leschi4banane/kugel-keyboard/pcb/kugel-keyboard.kicad_pcb

## KiCad design pcb/kugel-keyboard.kicad_pcb (2025-03-04)

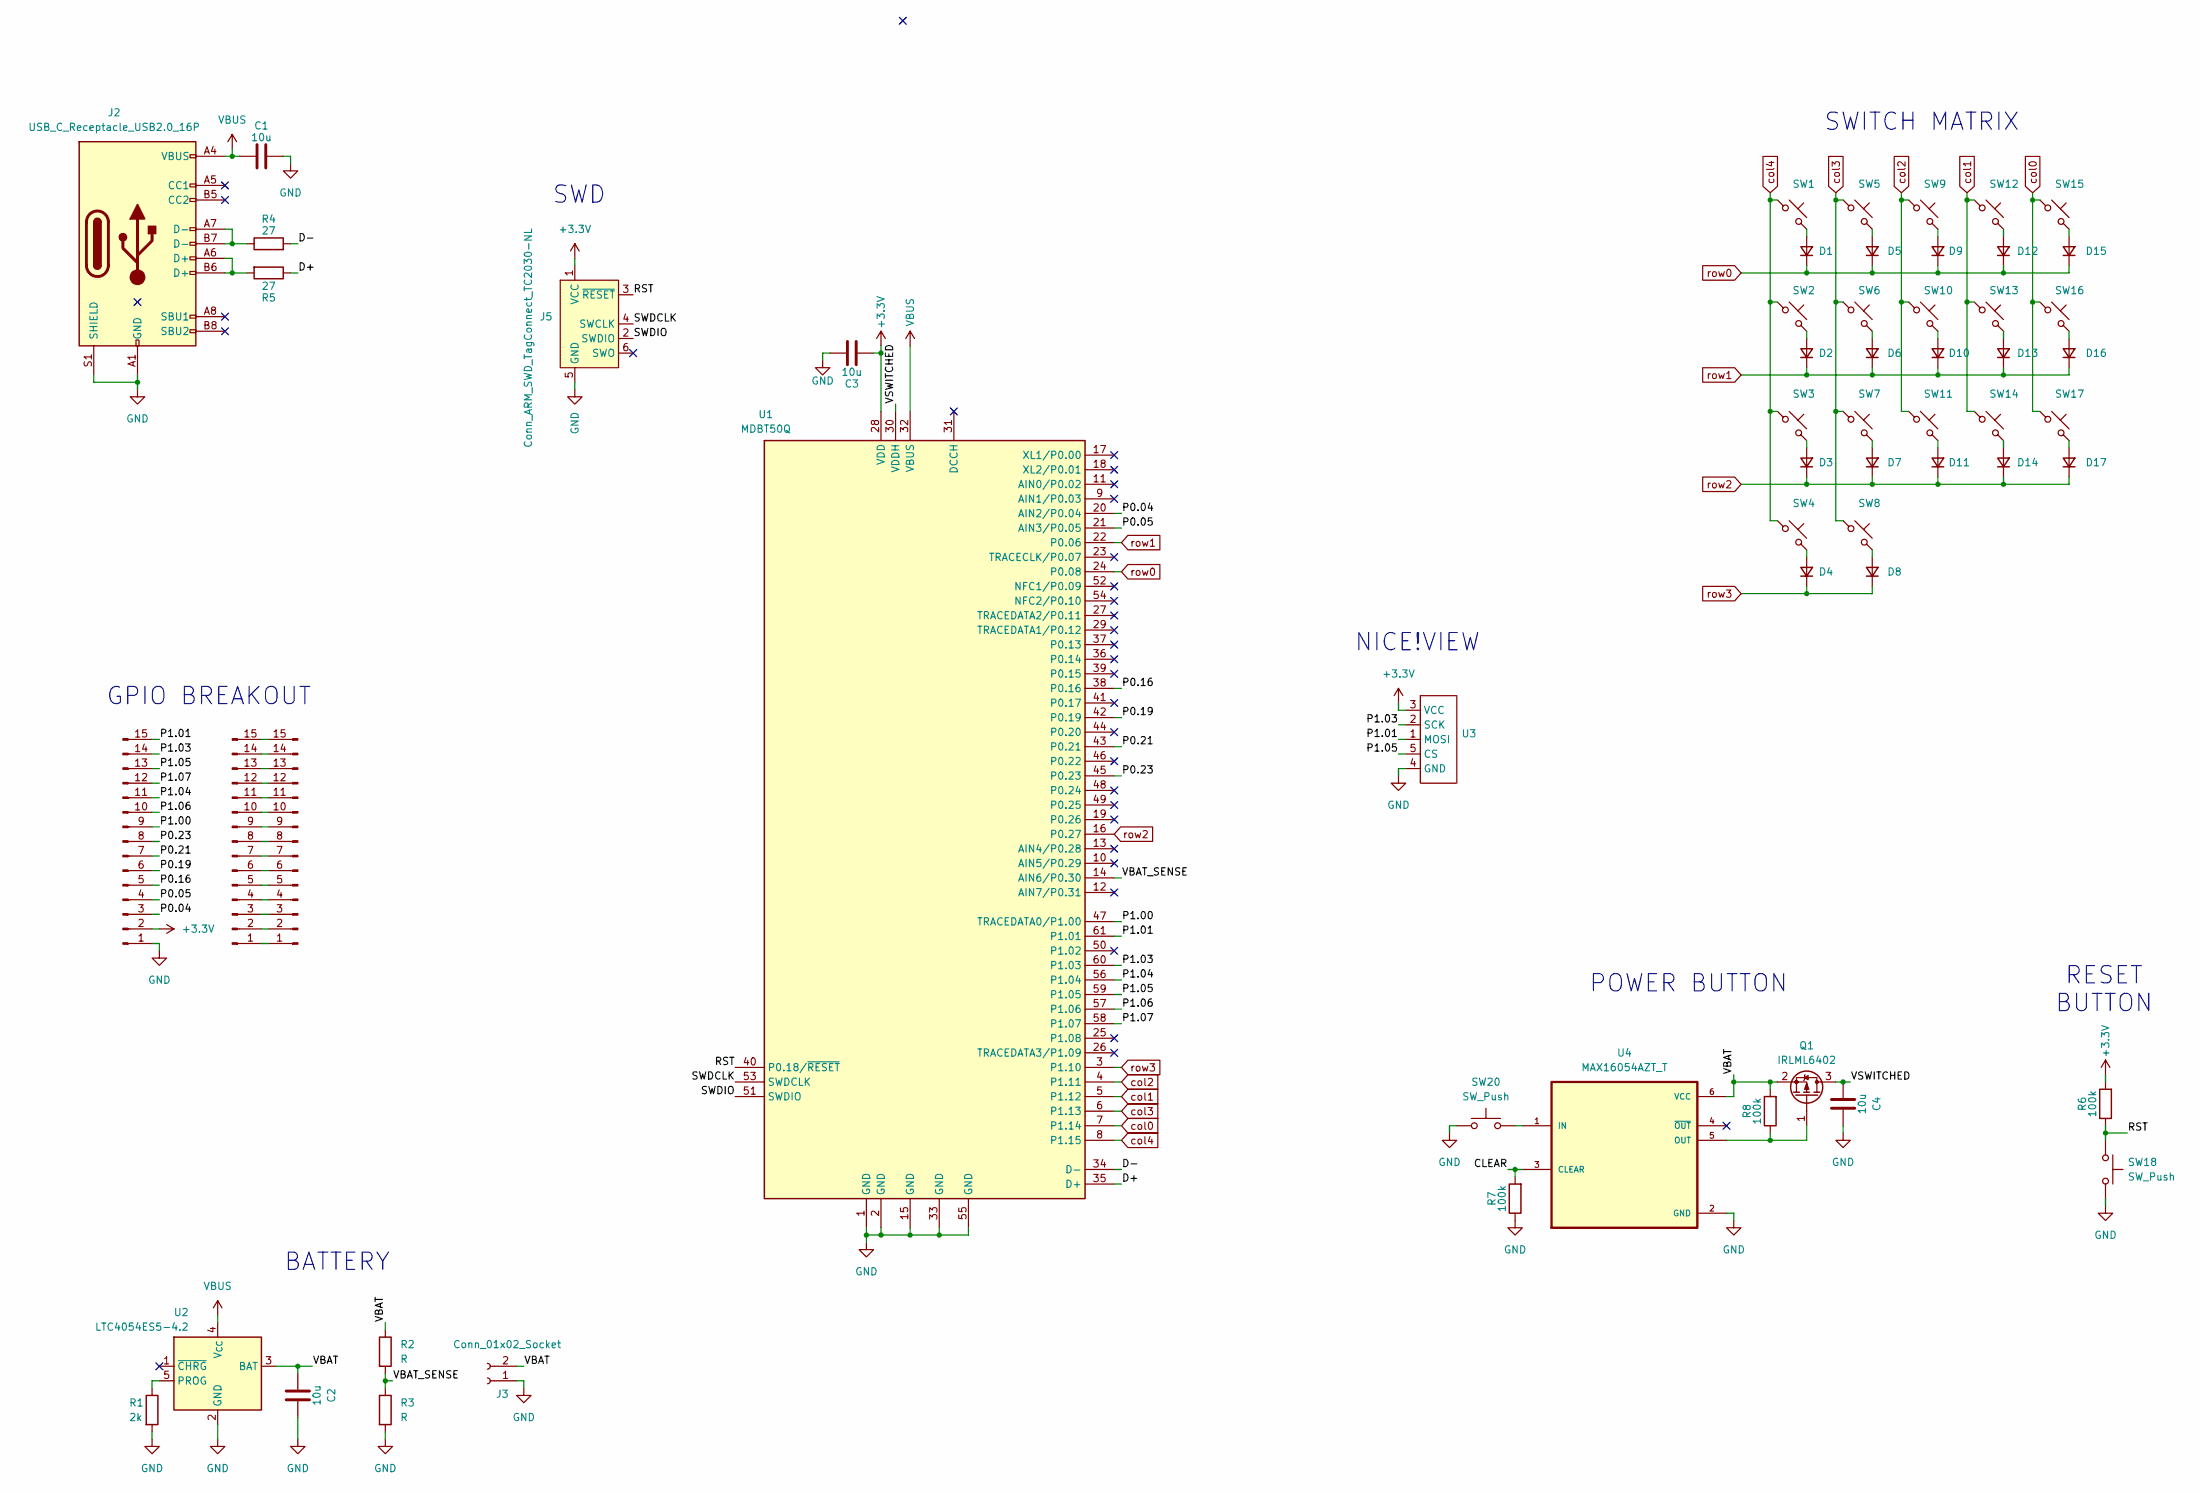
[picture p1: schematic kugel-keyboard.kicad_sch]

Parts:
C1, C2, C3, C4: 10u; C_0603_1608Metric_Pad1.08x0.95mm_HandSolder
D1, D2, D3, D4, D5, D6, D7, D8, D9, D10, D11, D12, D13, D14, D15, D16, D17: D_Small; Nexperia_CFP3_SOD-123W
J1, J6: Conn_01x15_Pin; Hirose_FH12-15S-0.5SH_1x15-1MP_P0.50mm_Horizontal
J2: USB_C_Receptacle_USB2.0_16P; USB_C_Receptacle_GCT_USB4105-xx-A_16P_TopMnt_Horizontal
J3: Conn_01x02_Socket; Battery_solder_pads
J4: Conn_01x15_Pin; PinHeader_1x15_P2.54mm_Vertical
J5: Conn_ARM_SWD_TagConnect_TC2030-NL; Tag-Connect_TC2030-IDC-NL_2x03_P1.27mm_Vertical
Q1: IRLML6402; SOT-23
R1: 2k; R_0603_1608Metric_Pad0.98x0.95mm_HandSolder
R2, R3: R; R_0603_1608Metric_Pad0.98x0.95mm_HandSolder
R4, R5: 27; R_0603_1608Metric_Pad0.98x0.95mm_HandSolder
R6, R7, R8: 100k; R_0603_1608Metric_Pad0.98x0.95mm_HandSolder
SW1, SW2, SW3, SW4, SW5, SW6, SW7, SW8, SW9, SW10, SW11, SW12, SW13, SW14, SW15, SW16, SW17: MX_SW_HS; Kailh_socket_PG1350
SW18, SW20: SW_Push; SW_TL6340AF160Q
U1: MDBT50Q; MDBT50Q-1MV2
U2: LTC4054ES5-4.2; TSOT-23-5
U3: nice!view
U4: MAX16054AZT_T; SOT95P275X110-6N

Connections:
+3.3V: C3.1, J5.1 (VCC), J6.2, R6.2, U1.28 (VDD), U3.3 (VCC)
/CLEAR: R7.2, U4.3 (CLEAR)
/D+: R5.1, U1.35 (D+)
/D-: R4.2, U1.34 (D-)
/P0.04: J6.3, U1.20 (AIN2/P0.04)
/P0.05: J6.4, U1.21 (AIN3/P0.05)
/P0.16: J6.5, U1.38 (P0.16)
/P0.19: J6.6, U1.42 (P0.19)
/P0.21: J6.7, U1.43 (P0.21)
/P0.23: J6.8, U1.45 (P0.23)
/P1.00: J6.9, U1.47 (TRACEDATA0/P1.00)
/P1.01: J6.15, U1.61 (P1.01), U3.1 (MOSI)
/P1.03: J6.14, U1.60 (P1.03), U3.2 (SCK)
/P1.04: J6.11, U1.56 (P1.04)
/P1.05: J6.13, U1.59 (P1.05), U3.5 (CS)
/P1.06: J6.10, U1.57 (P1.06)
/P1.07: J6.12, U1.58 (P1.07)
/RST: J5.3 (~RESET), R6.1, SW18.1, U1.40 (P0.18/~RESET)
/SWDCLK: J5.4 (SWCLK), U1.53 (SWDCLK)
/SWDIO: J5.2 (SWDIO), U1.51 (SWDIO)
/VBAT: C2.1, J3.2, Q1.2 (S), R2.1, R8.2, U2.3 (BAT), U4.6 (VCC)
/VBAT_SENSE: R2.2, R3.1, U1.14 (AIN6/P0.30)
/VSWITCHED: C4.1, Q1.3 (D), U1.30 (VDDH)
GND: C1.2, C2.2, C3.2, C4.2, J2.A1 (GND), J2.A12 (GND), J2.B1 (GND), J2.B12 (GND), J2.S1 (SHIELD), J3.1, J5.5 (GND), J6.1, J6.MP, R1.2, R3.2, R7.1, SW18.2, SW20.1, U1.1 (GND), U1.2 (GND), U1.15 (GND), U1.33 (GND), U1.55 (GND), U2.2 (GND), U3.4 (GND), U4.2 (GND)
unnamed: D1.2 (A), SW1.2
unnamed: D2.2 (A), SW2.2
unnamed: D3.2 (A), SW3.2
unnamed: D4.2 (A), SW4.2
unnamed: D5.2 (A), SW5.2
unnamed: D6.2 (A), SW6.2
unnamed: D7.2 (A), SW7.2
unnamed: D8.2 (A), SW8.2
unnamed: D9.2 (A), SW9.2
unnamed: D10.2 (A), SW10.2
unnamed: D11.2 (A), SW11.2
unnamed: D12.2 (A), SW12.2
unnamed: D13.2 (A), SW13.2
unnamed: D14.2 (A), SW14.2
unnamed: D15.2 (A), SW15.2
unnamed: D16.2 (A), SW16.2
unnamed: D17.2 (A), SW17.2
unnamed: J1.1, J4.1
unnamed: J1.2, J4.2
unnamed: J1.3, J4.3
unnamed: J1.4, J4.4
unnamed: J1.5, J4.5
unnamed: J1.6, J4.6
unnamed: J1.7, J4.7
unnamed: J1.8, J4.8
unnamed: J1.9, J4.9
unnamed: J1.10, J4.10
unnamed: J1.11, J4.11
unnamed: J1.12, J4.12
unnamed: J1.13, J4.13
unnamed: J1.14, J4.14
unnamed: J1.15, J4.15
unnamed: J2.A6 (D+), J2.B6 (D+), R5.2
unnamed: J2.A7 (D-), J2.B7 (D-), R4.1
unnamed: Q1.1 (G), R8.1, U4.5 (OUT)
unnamed: R1.1, U2.5 (PROG)
unnamed: SW20.2, U4.1 (IN)
VBUS: C1.1, J2.A4 (VBUS), J2.A9 (VBUS), J2.B4 (VBUS), J2.B9 (VBUS), U1.32 (VBUS), U2.4 (V_{CC})
col0: SW15.1, SW16.1, SW17.1, U1.7 (P1.14)
col1: SW12.1, SW13.1, SW14.1, U1.5 (P1.12)
col2: SW9.1, SW10.1, SW11.1, U1.4 (P1.11)
col3: SW5.1, SW6.1, SW7.1, SW8.1, U1.6 (P1.13)
col4: SW1.1, SW2.1, SW3.1, SW4.1, U1.8 (P1.15)
row0: D1.1 (K), D5.1 (K), D9.1 (K), D12.1 (K), D15.1 (K), U1.24 (P0.08)
row1: D2.1 (K), D6.1 (K), D10.1 (K), D13.1 (K), D16.1 (K), U1.22 (P0.06)
row2: D3.1 (K), D7.1 (K), D11.1 (K), D14.1 (K), D17.1 (K), U1.16 (P0.27)
row3: D4.1 (K), D8.1 (K), U1.3 (P1.10)

Notes on the sheet:
RESET BUTTON
GPIO BREAKOUT
NICE!VIEW
POWER BUTTON
SWITCH MATRIX
SWD
BATTERY

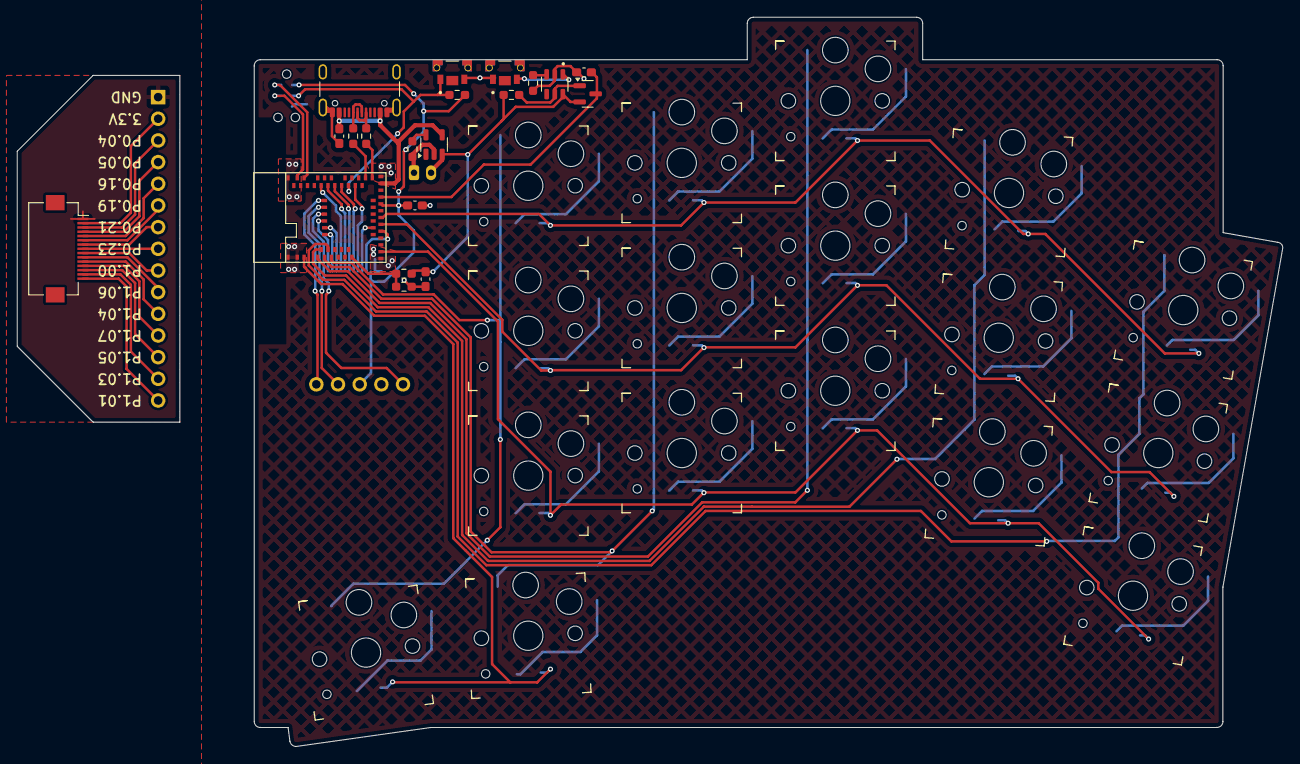
[picture p2: board kugel-keyboard.kicad_pcb from above]

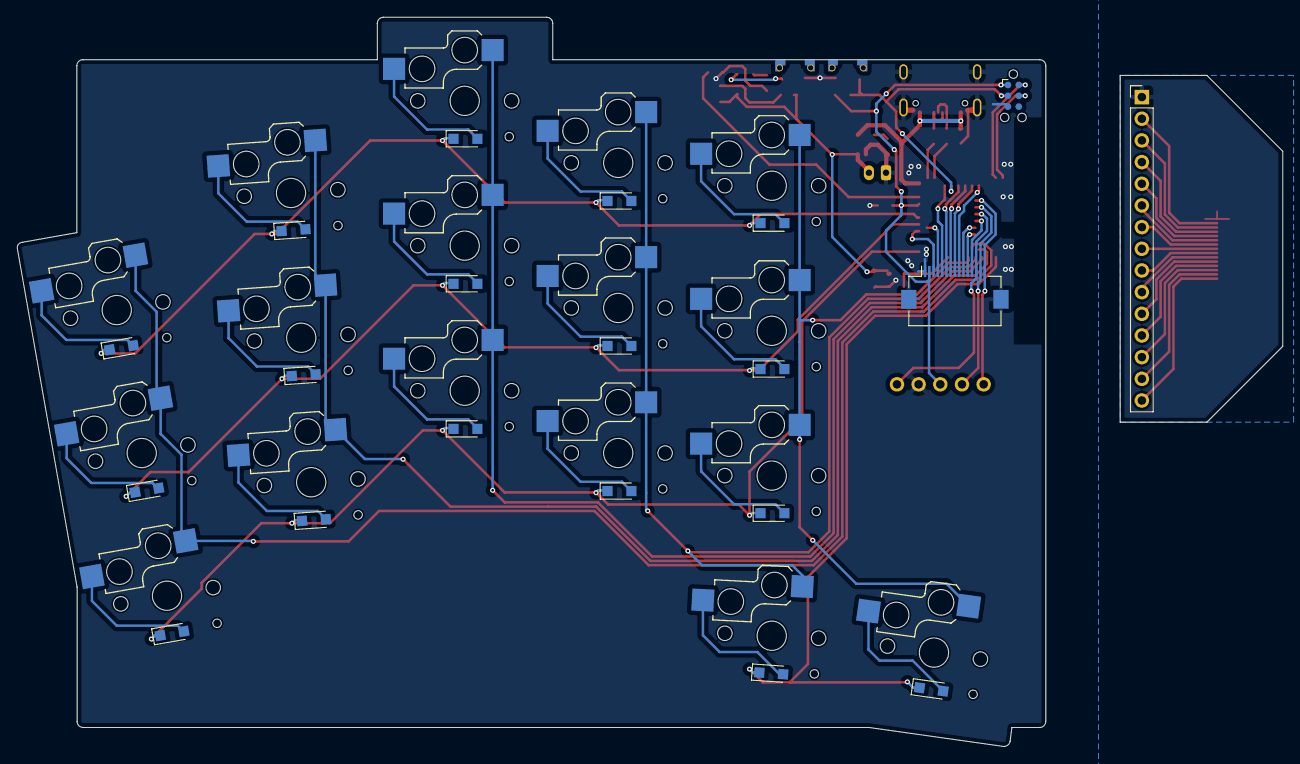
[picture p3: board kugel-keyboard.kicad_pcb from below]

Board: 2 copper layers, 120.5 x 85.5 mm, 59 parts (20 on the bottom side), 71 nets.
