leschi4banane/kugel-keyboard/TODO.md

# TODO
## schematic & layout
- mcu with programming over usb-c
- lithium charge cicuit
- buttons
  - main key matrix
  - reset
  - power (with circuit to act as switch)
- breakout of unused pins for further testing
- breakout for niceview display
