leschi4banane/kugel-keyboard/(commit log)

2025-02-25 added reference materials
2025-02-25 added physical key positions
    [kugel-keyboard.kicad_pcb, kugel-keyboard.kicad_sch]
2025-02-25 removed and ignored kicad backups
2025-02-25 moved led-test module to sperate git repo
2025-03-04 added right side PCB and GPIO breakout PCB
    [kugel-keyboard.kicad_pcb, kugel-keyboard.kicad_sch]
2025-03-11 added left side PCB and GPIO breakout PCB
    [kugel-keyboard.kicad_sch, left.kicad_sch, right.kicad_sch]
2025-03-18 added ESD-protection
    [left.kicad_sch, right.kicad_sch]
2025-03-18 added external oszilator
    [bom.csv, kugel-keyboard.kicad_sch, left.kicad_sch, right.kicad_sch]
2025-03-18 replaced charge circuit for cost reasons
    [bom.csv, left.kicad_sch, right.kicad_sch]
2025-03-19 replaced button ic and updated bom
    [bom.csv, left.kicad_sch, right.kicad_sch]
